0x007E/tgn/mechanical/housing.FCStd

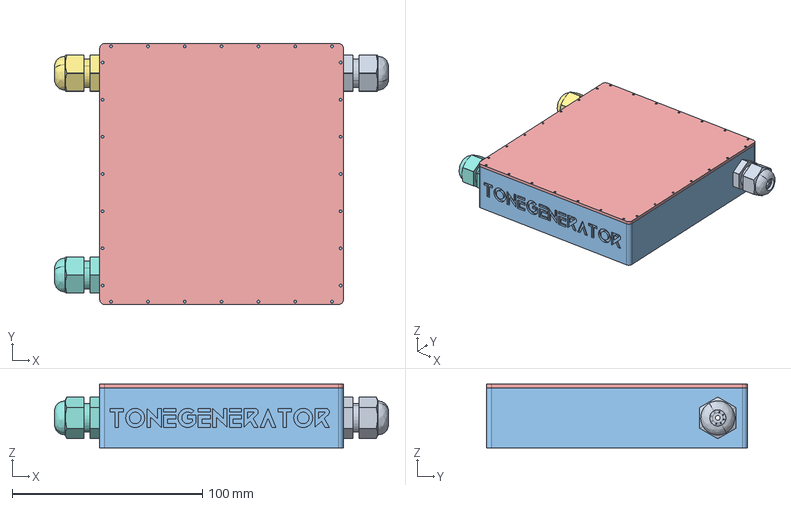
[picture p1: CAD file, 2026-04-13]
mechanical/housing.FCStd
175.5 x 137.1 x 33.5 mm
Pcb_bf5f
J8_TerminalBlock_Phoenix_MKDS_15_2_508_1x02_P508mm_Horizontal_966042dcc371
RV1_Potentiometer_Bourns_3296W_Vertical_bd6c58a47347
R2_R_Axial_DIN0207_L63mm_D25mm_P1016mm_Horizontal_2f8f7165bda0
R5_R_Axial_DIN0207_L63mm_D25mm_P1016mm_Horizontal_7338e84fdc98
R9_R_Axial_DIN0207_L63mm_D25mm_P1016mm_Horizontal_2fbd2a20d477
C22_CP_Radial_D80mm_P350mm_770ae233401d
R21_R_Axial_DIN0207_L63mm_D25mm_P1016mm_Horizontal_0408edf33882
R24_R_Axial_DIN0207_L63mm_D25mm_P1016mm_Horizontal_a47f8ef12ceb
D2_LED_D5.0mm_b938de95e8e3
R28_R_Axial_DIN0207_L63mm_D25mm_P1016mm_Horizontal_7c2d55b14bf2
J11_PinHeader_1x03_P254mm_Vertical_755d7d74a0a2
R19_R_Axial_DIN0207_L63mm_D25mm_P1016mm_Horizontal_fe28b3a22ee2
Q1_TO-92_Wide_a5516702e934
J7_TerminalBlock_Phoenix_MKDS_15_2_508_1x02_P508mm_Horizontal_5398f9b25835
C2_CP_Radial_D80mm_P350mm_c936b49940e3
R13_R_Axial_DIN0207_L63mm_D25mm_P1016mm_Horizontal_583937bb0d57
C12_C_Disc_D50mm_W25mm_P250mm_c4d23a535d06
C16_C_Disc_D50mm_W25mm_P250mm_a4bcc5b5eeba
R27_R_Axial_DIN0207_L63mm_D25mm_P1016mm_Horizontal_b2bb33a8434a
J9_TerminalBlock_Phoenix_MKDS_15_2_508_1x02_P508mm_Horizontal_ed7d2c41be30
U11_DIP_8_W762mm_Socket_48e19bc4034c
C4_CP_Radial_D80mm_P350mm_f4ba60a29ce0
J3_PinHeader_1x02_P254mm_Vertical_3cade2f9eb17
R25_R_Axial_DIN0207_L63mm_D25mm_P1016mm_Horizontal_3ad7011eaaed
U6_DIP_16_W762mm_Socket_05c4fef0970c
C10_C_Disc_D50mm_W25mm_P250mm_e466ce81a680
C15_C_Disc_D50mm_W25mm_P250mm_6bec329688ee
J12_PinHeader_1x03_P254mm_Vertical_b2e7384c09ff
U3_DIP_14_W762mm_Socket_77d9b751a4c5
R3_R_Axial_DIN0207_L63mm_D25mm_P1016mm_Horizontal_e1384053c9d4
U9_DIP_8_W762mm_Socket_c7e6118ec233
U2_DIP_14_W762mm_Socket_1d6f5387526a
J6_PinHeader_1x03_P254mm_Vertical_416229293399
LS1_TerminalBlock_Phoenix_MKDS_15_2_508_1x02_P508mm_Horizontal_cf348314c129
C14_C_Disc_D50mm_W25mm_P250mm_362b8cfb6720
R7_R_Axial_DIN0207_L63mm_D25mm_P1016mm_Horizontal_4b6fb19448ef
R10_R_Axial_DIN0207_L63mm_D25mm_P1016mm_Horizontal_2cd78269121d
U8_DIP_16_W762mm_Socket_b1bc0039ac66
R30_R_Axial_DIN0207_L63mm_D25mm_P1016mm_Horizontal_cbc60847cbaa
C7_C_Disc_D50mm_W25mm_P250mm_bb85d0389fc8
C3_CP_Radial_D80mm_P350mm_c63e61aa70d5
J1_TerminalBlock_Phoenix_MKDS_15_2_508_1x02_P508mm_Horizontal_a53db4caa078
U5_DIP_16_W762mm_Socket_3ae7070fdcc8
R15_R_Axial_DIN0207_L63mm_D25mm_P1016mm_Horizontal_7a1509dda514
C11_C_Disc_D50mm_W25mm_P250mm_a5813d64c108
R14_R_Axial_DIN0207_L63mm_D25mm_P1016mm_Horizontal_d6deb1070b43
R29_R_Axial_DIN0207_L63mm_D25mm_P1016mm_Horizontal_8874abd8c114
J4_PinHeader_1x02_P254mm_Vertical_619bb45d0a5d
F1_100056_ef463b47df8c
F1_100056_ef463b47df8c[2]
U7_DIP_16_W762mm_Socket_4d8cd030cd80
J2_PinHeader_1x02_P254mm_Vertical_04cdee413f5e
D1_D_DO-201_P15.24mm_Horizontal_fedca64ea0a4
C17_C_Disc_D50mm_W25mm_P250mm_d6f6ce41cef2
C5_CP_Radial_D80mm_P350mm_bb47d8a898b0
R8_R_Axial_DIN0207_L63mm_D25mm_P1016mm_Horizontal_bda0a483a1b2
R11_R_Axial_DIN0207_L63mm_D25mm_P1016mm_Horizontal_5b285d104ccb
C18_C_Disc_D50mm_W25mm_P250mm_e7fd411ce769
Q2_TO-92_Wide_e51d8f50bd00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
