0x007E/tgn/pcb/TGN.kicad_pcb

## KiCad design pcb/TGN.kicad_pcb (2026-04-12)

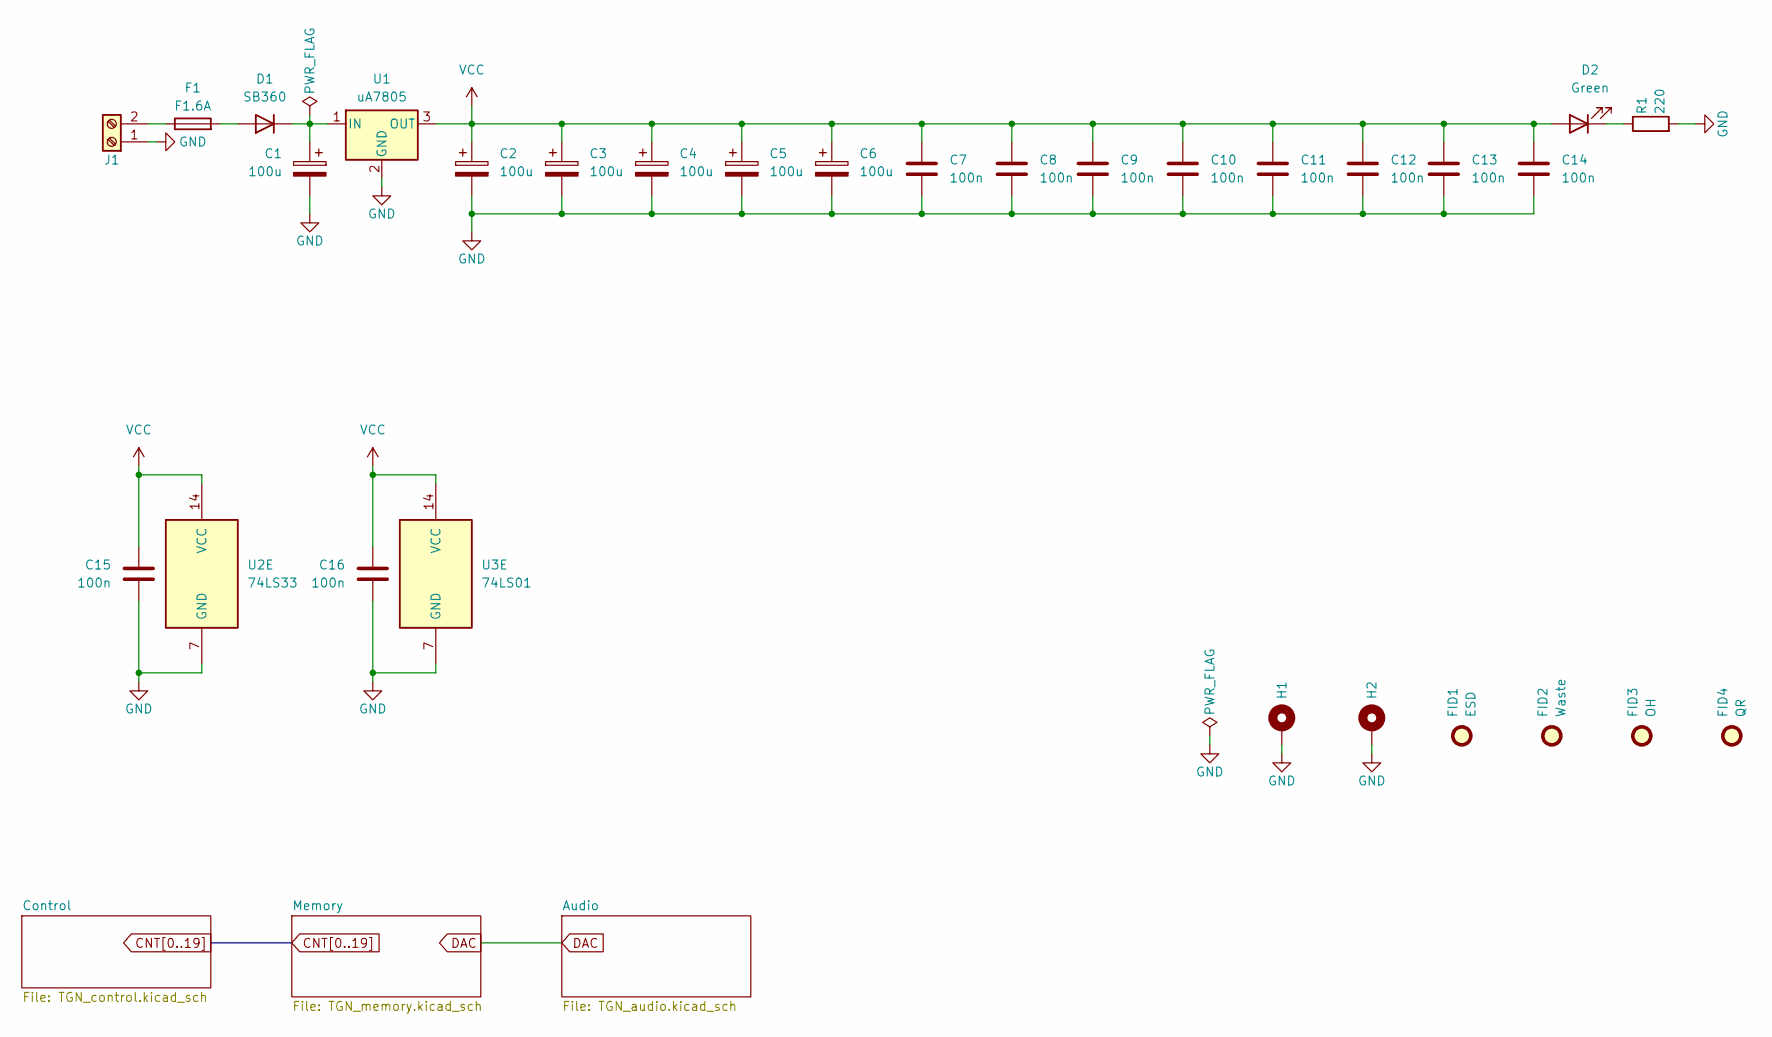
[picture p2: schematic TGN.kicad_sch, ${acronym} - ${title}]

Parts:
C1, C2, C3, C4, C5, C6: 100u; CP_Radial_D8.0mm_P3.50mm
C7, C8, C9, C10, C11, C12, C13, C14, C15, C16: 100n; C_Disc_D5.0mm_W2.5mm_P2.50mm
D1: SB360; D_DO-201_P15.24mm_Horizontal
D2: Green; LED_D5.0mm
F1: F1.6A; Fuse_20mm_HTL
FID1: ESD; ESD-Logo_6.6x6mm_SilkScreen
FID2: Waste; WEEE-Logo_4.2x6mm_SilkScreen
FID3: OH; OSHW-Logo_5.7x6mm_SilkScreen
FID4: QR; QR_0x007e_small
H1, H2: MountingHole_Pad; MountingHole_3.2mm_M3_Pad
J1: Screw_Terminal_01x02; TerminalBlock_Phoenix_MKDS-1,5-2-5.08_1x02_P5.08mm_Horizont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
R1: 220; R_Axial_DIN0207_L6.3mm_D2.5mm_P10.16mm_Horizontal
U1: uA7805; TO-220-3_Vertical
U2: 74LS33; DIP-14_W7.62mm_Socket_LongPads
U3: 74LS01; DIP-14_W7.62mm_Socket_LongPads

Connections:
GND: C1.2, C2.2, C3.2, C4.2, C5.2, C6.2, C7.2, C8.2, C9.2, C10.2, C11.2, C12.2, C13.2, C14.2, C15.2, C16.2, H1.1, H2.1, J1.1, R1.2, U1.2 (GND), U2.7 (GND), U3.7 (GND); also elsewhere on the board
unnamed: D1.2 (A), F1.2
unnamed: C1.1, D1.1 (K), U1.1 (IN)
unnamed: D2.1 (K), R1.1
unnamed: F1.1, J1.2
VCC: C2.1, C3.1, C4.1, C5.1, C6.1, C7.1, C8.1, C9.1, C10.1, C11.1, C12.1, C13.1, C14.1, C15.1, C16.1, D2.2 (A), U1.3 (OUT), U2.14 (VCC), U3.14 (VCC); also elsewhere on the board

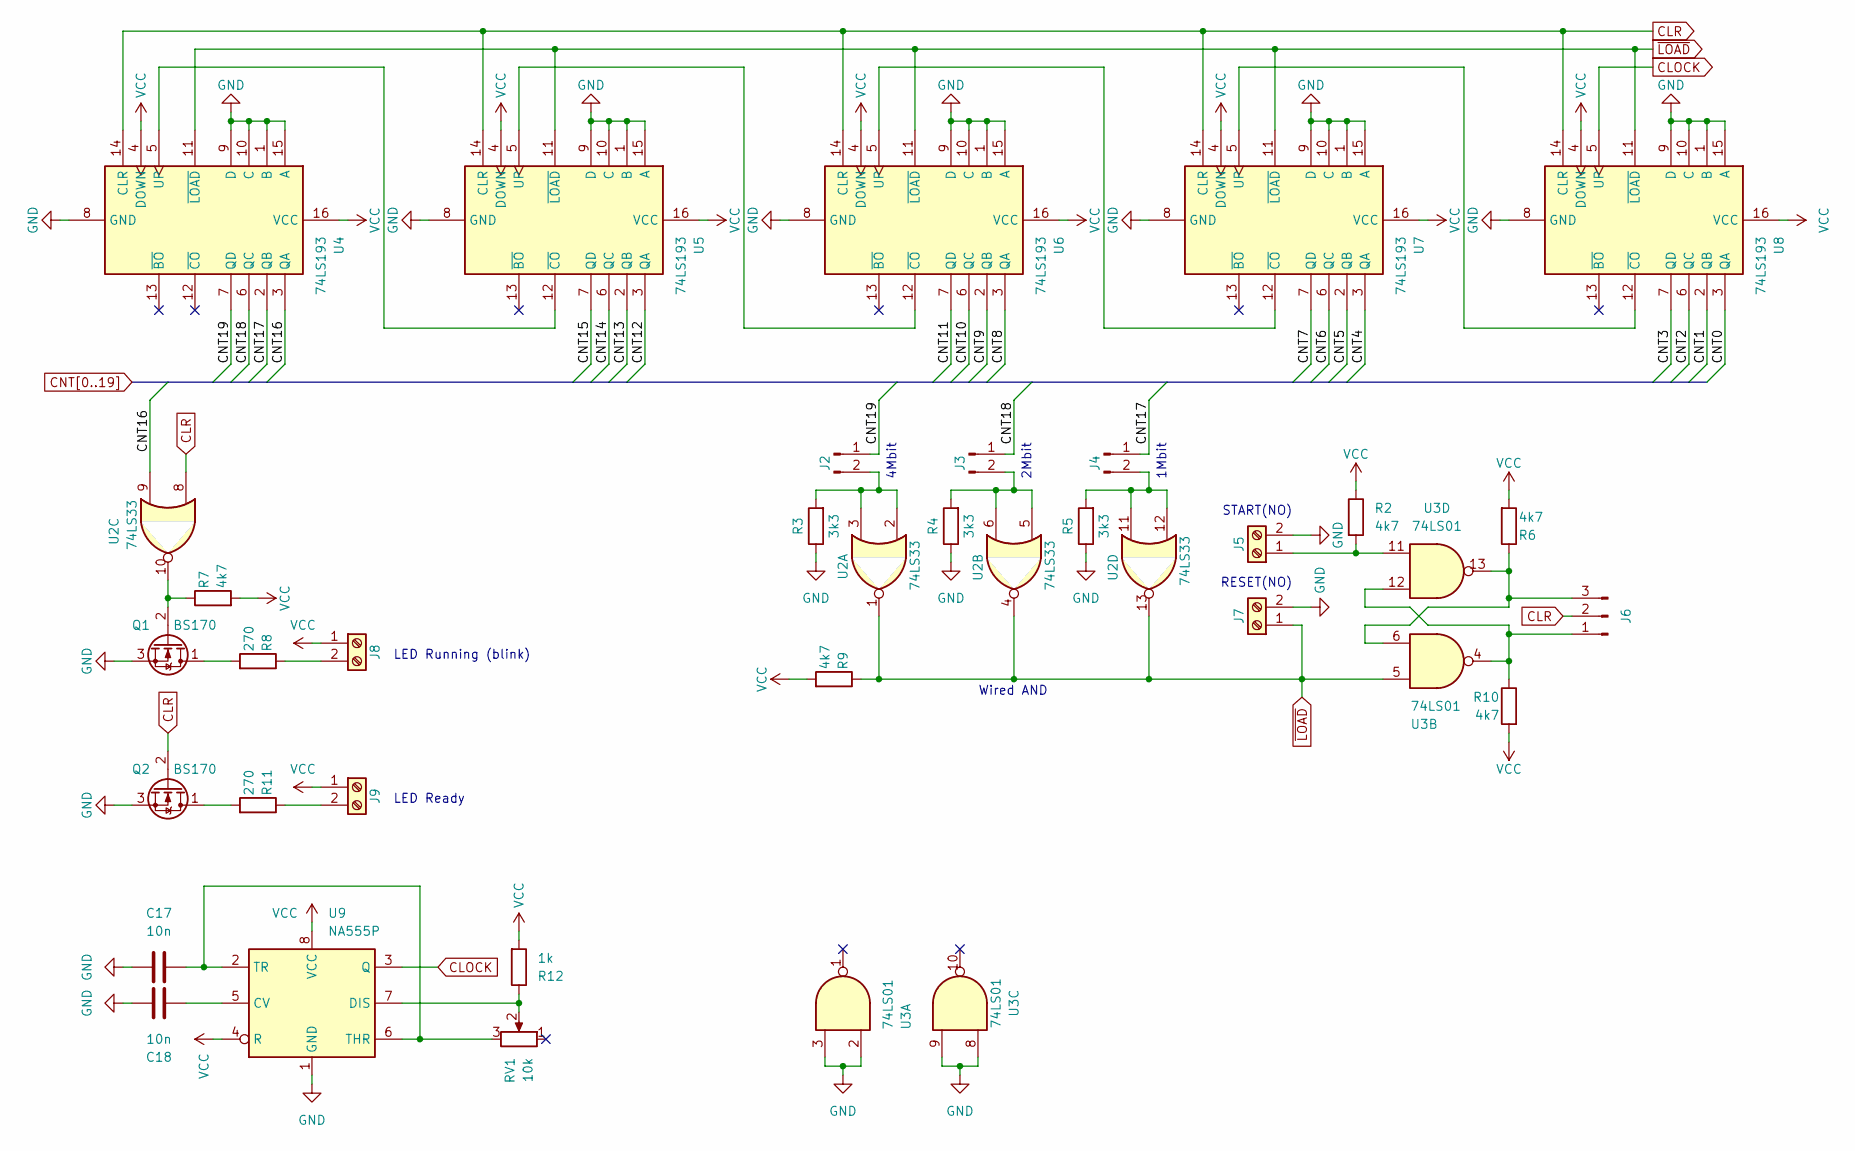
[picture p3: schematic TGN_control.kicad_sch, ${acronym} - ${title}]

Parts:
C17, C18: 10n; C_Disc_D5.0mm_W2.5mm_P2.50mm
J2, J3, J4: Conn_01x02_Pin; PinHeader_1x02_P2.54mm_Vertical
J5, J7, J8, J9: Screw_Terminal_01x02; TerminalBlock_Phoenix_MKDS-1,5-2-5.08_1x02_P5.08mm_Horizont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
J6: Conn_01x03_Pin; PinHeader_1x03_P2.54mm_Vertical
Q1, Q2: BS170; TO-92_Wide
R2, R6, R7, R9, R10: 4k7; R_Axial_DIN0207_L6.3mm_D2.5mm_P10.16mm_Horizontal
R3, R4, R5: 3k3; R_Axial_DIN0207_L6.3mm_D2.5mm_P10.16mm_Horizontal
R8, R11: 270; R_Axial_DIN0207_L6.3mm_D2.5mm_P10.16mm_Horizontal
R12: 1k; R_Axial_DIN0207_L6.3mm_D2.5mm_P10.16mm_Horizontal
RV1: 10k; Potentiometer_Bourns_3296W_Vertical
U2: 74LS33; DIP-14_W7.62mm_Socket_LongPads
U3: 74LS01; DIP-14_W7.62mm_Socket_LongPads
U4, U5, U6, U7, U8: 74LS193; DIP-16_W7.62mm_Socket_LongPads
U9: NA555P; DIP-8_W7.62mm_Socket_LongPads

Connections:
CLOCK: U8.5 (UP), U9.3 (Q)
CLR: J6.2, Q2.2 (G), U2.8, U4.14 (CLR), U5.14 (CLR), U6.14 (CLR), U7.14 (CLR), U8.14 (CLR)
CNT0: U8.3 (QA); also elsewhere on the board
CNT1: U8.2 (QB); also elsewhere on the board
CNT2: U8.6 (QC); also elsewhere on the board
CNT3: U8.7 (QD); also elsewhere on the board
CNT4: U7.3 (QA); also elsewhere on the board
CNT5: U7.2 (QB); also elsewhere on the board
CNT6: U7.6 (QC); also elsewhere on the board
CNT7: U7.7 (QD); also elsewhere on the board
CNT8: U6.3 (QA); also elsewhere on the board
CNT9: U6.2 (QB); also elsewhere on the board
CNT10: U6.6 (QC); also elsewhere on the board
CNT11: U6.7 (QD); also elsewhere on the board
CNT12: U5.3 (QA); also elsewhere on the board
CNT13: U5.2 (QB); also elsewhere on the board
CNT14: U5.6 (QC); also elsewhere on the board
CNT15: U5.7 (QD); also elsewhere on the board
CNT16: U2.9, U4.3 (QA); also elsewhere on the board
CNT17: J4.1, U4.2 (QB); also elsewhere on the board
CNT18: J3.1, U4.6 (QC); also elsewhere on the board
CNT19: J2.1, U4.7 (QD)
GND: C17.1, C18.1, J5.2, J7.2, Q1.3 (S), Q2.3 (S), R3.1, R4.1, R5.1, U3.2, U3.3, U3.8, U3.9, U4.1 (B), U4.8 (GND), U4.9 (D), U4.10 (C), U4.15 (A), U5.1 (B), U5.8 (GND), U5.9 (D), U5.10 (C), U5.15 (A), U6.1 (B), U6.8 (GND), U6.9 (D), U6.10 (C), U6.15 (A), U7.1 (B), U7.8 (GND), U7.9 (D), U7.10 (C), U7.15 (A), U8.1 (B), U8.8 (GND), U8.9 (D), U8.10 (C), U8.15 (A), U9.1 (GND); also elsewhere on the board
unnamed: J2.2, R3.2, U2.2, U2.3
unnamed: J3.2, R4.2, U2.5, U2.6
unnamed: J4.2, R5.2, U2.11, U2.12
unnamed: J5.1, R2.2, U3.11
unnamed: J6.1, R10.1, U3.4, U3.12
unnamed: J6.3, R6.1, U3.6, U3.13
unnamed: J8.2, R8.1
unnamed: J9.2, R11.1
unnamed: Q1.1 (D), R8.2
unnamed: Q1.2 (G), R7.1, U2.10
unnamed: Q2.1 (D), R11.2
unnamed: U4.5 (UP), U5.12 (~CO)
unnamed: U5.5 (UP), U6.12 (~CO)
unnamed: U6.5 (UP), U7.12 (~CO)
unnamed: U7.5 (UP), U8.12 (~CO)
unnamed: C18.2, U9.5 (CV)
unnamed: R12.1, RV1.2, U9.7 (DIS)
unnamed: C17.2, RV1.3, U9.2 (TR), U9.6 (THR)
VCC: J8.1, J9.1, R2.1, R6.2, R7.2, R9.2, R10.2, R12.2, U4.4 (DOWN), U4.16 (VCC), U5.4 (DOWN), U5.16 (VCC), U6.4 (DOWN), U6.16 (VCC), U7.4 (DOWN), U7.16 (VCC), U8.4 (DOWN), U8.16 (VCC), U9.4 (R), U9.8 (VCC); also elsewhere on the board
~LOAD: J7.1, R9.1, U2.1, U2.4, U2.13, U3.5, U4.11 (~LOAD), U5.11 (~LOAD), U6.11 (~LOAD), U7.11 (~LOAD), U8.11 (~LOAD)

Notes on the sheet:
Wired AND
2Mbit
4Mbit
LED Ready
1Mbit
LED Running (blink)
RESET(NO)
START(NO)

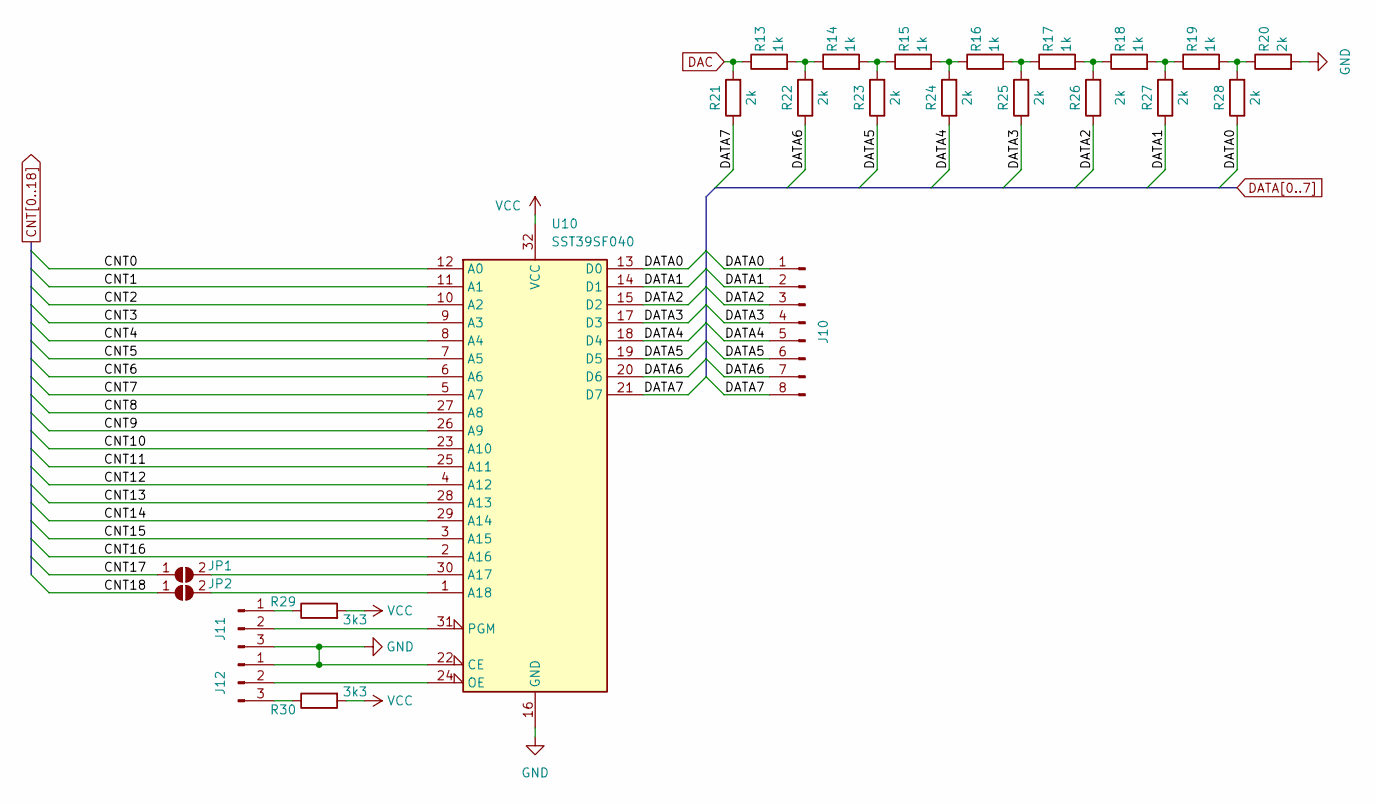
[picture p4: schematic TGN_memory.kicad_sch, ${acronym} - ${title}]

Parts:
J10: Conn_01x08_Pin; PinSocket_1x08_P2.54mm_Vertical
J11, J12: Conn_01x03_Pin; PinHeader_1x03_P2.54mm_Vertical
JP1, JP2: SolderJumper_2_Open; SolderJumper-2_P1.3mm_Open_RoundedPad1.0x1.5mm
R13, R14, R15, R16, R17, R18, R19: 1k; R_Axial_DIN0207_L6.3mm_D2.5mm_P10.16mm_Horizontal
R20, R21, R22, R23, R24, R25, R26, R27, R28: 2k; R_Axial_DIN0207_L6.3mm_D2.5mm_P10.16mm_Horizontal
R29, R30: 3k3; R_Axial_DIN0207_L6.3mm_D2.5mm_P10.16mm_Horizontal
U10: SST39SF040; DIP-32_W15.24mm_LongPads

Connections:
CNT0: U10.12 (A0); also elsewhere on the board
CNT1: U10.11 (A1); also elsewhere on the board
CNT2: U10.10 (A2); also elsewhere on the board
CNT3: U10.9 (A3); also elsewhere on the board
CNT4: U10.8 (A4); also elsewhere on the board
CNT5: U10.7 (A5); also elsewhere on the board
CNT6: U10.6 (A6); also elsewhere on the board
CNT7: U10.5 (A7); also elsewhere on the board
CNT8: U10.27 (A8); also elsewhere on the board
CNT9: U10.26 (A9); also elsewhere on the board
CNT10: U10.23 (A10); also elsewhere on the board
CNT11: U10.25 (A11); also elsewhere on the board
CNT12: U10.4 (A12); also elsewhere on the board
CNT13: U10.28 (A13); also elsewhere on the board
CNT14: U10.29 (A14); also elsewhere on the board
CNT15: U10.3 (A15); also elsewhere on the board
CNT16: U10.2 (A16); also elsewhere on the board
CNT17: JP1.1 (A); also elsewhere on the board
CNT18: JP2.1 (A); also elsewhere on the board
DAC: R13.1, R21.2; also elsewhere on the board
DATA0: J10.1, R28.1, U10.13 (D0)
DATA1: J10.2, R27.1, U10.14 (D1)
DATA2: J10.3, R26.1, U10.15 (D2)
DATA3: J10.4, R25.1, U10.17 (D3)
DATA4: J10.5, R24.1, U10.18 (D4)
DATA5: J10.6, R23.1, U10.19 (D5)
DATA6: J10.7, R22.1, U10.20 (D6)
DATA7: J10.8, R21.1, U10.21 (D7)
GND: J11.3, J12.1, R20.2, U10.16 (GND), U10.22 (CE); also elsewhere on the board
unnamed: J11.1, R29.1
unnamed: J11.2, U10.31 (PGM)
unnamed: J12.2, U10.24 (OE)
unnamed: J12.3, R30.1
unnamed: JP1.2 (B), U10.30 (A17)
unnamed: JP2.2 (B), U10.1 (A18)
unnamed: R13.2, R14.1, R22.2
unnamed: R14.2, R15.1, R23.2
unnamed: R15.2, R16.1, R24.2
unnamed: R16.2, R17.1, R25.2
unnamed: R17.2, R18.1, R26.2
unnamed: R18.2, R19.1, R27.2
unnamed: R19.2, R20.1, R28.2
VCC: R29.2, R30.2, U10.32 (VCC); also elsewhere on the board

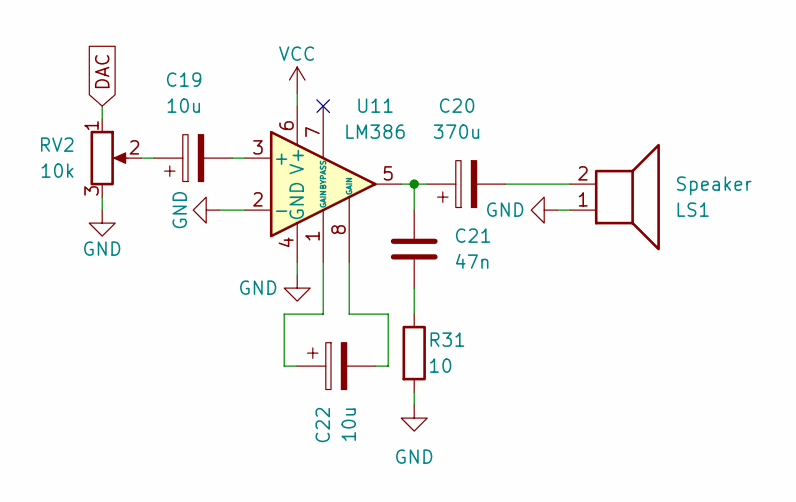
[picture p5: schematic TGN_audio.kicad_sch, ${acronym} - ${title}]

Parts:
C19, C22: 10u; CP_Radial_D8.0mm_P3.50mm
C20: 370u; CP_Radial_D8.0mm_P3.50mm
C21: 47n; C_Disc_D5.0mm_W2.5mm_P2.50mm
LS1: Speaker; TerminalBlock_Phoenix_MKDS-1,5-2-5.08_1x02_P5.08mm_Horizont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
R31: 10; R_Axial_DIN0207_L6.3mm_D2.5mm_P10.16mm_Horizontal
RV2: 10k; Potentiometer_Piher_PT-10-V10_Vertical
U11: LM386; DIP-8_W7.62mm_Socket_LongPads

Connections:
DAC: RV2.1; also elsewhere on the board
GND: LS1.1, R31.2, RV2.3, U11.2 (-), U11.4 (GND); also elsewhere on the board
unnamed: C19.1, RV2.2
unnamed: C20.1, C21.1, U11.5
unnamed: C20.2, LS1.2
unnamed: C21.2, R31.1
unnamed: C22.1, U11.1 (GAIN)
unnamed: C22.2, U11.8 (GAIN)
unnamed: C19.2, U11.3 (+)
VCC: U11.6 (V+); also elsewhere on the board

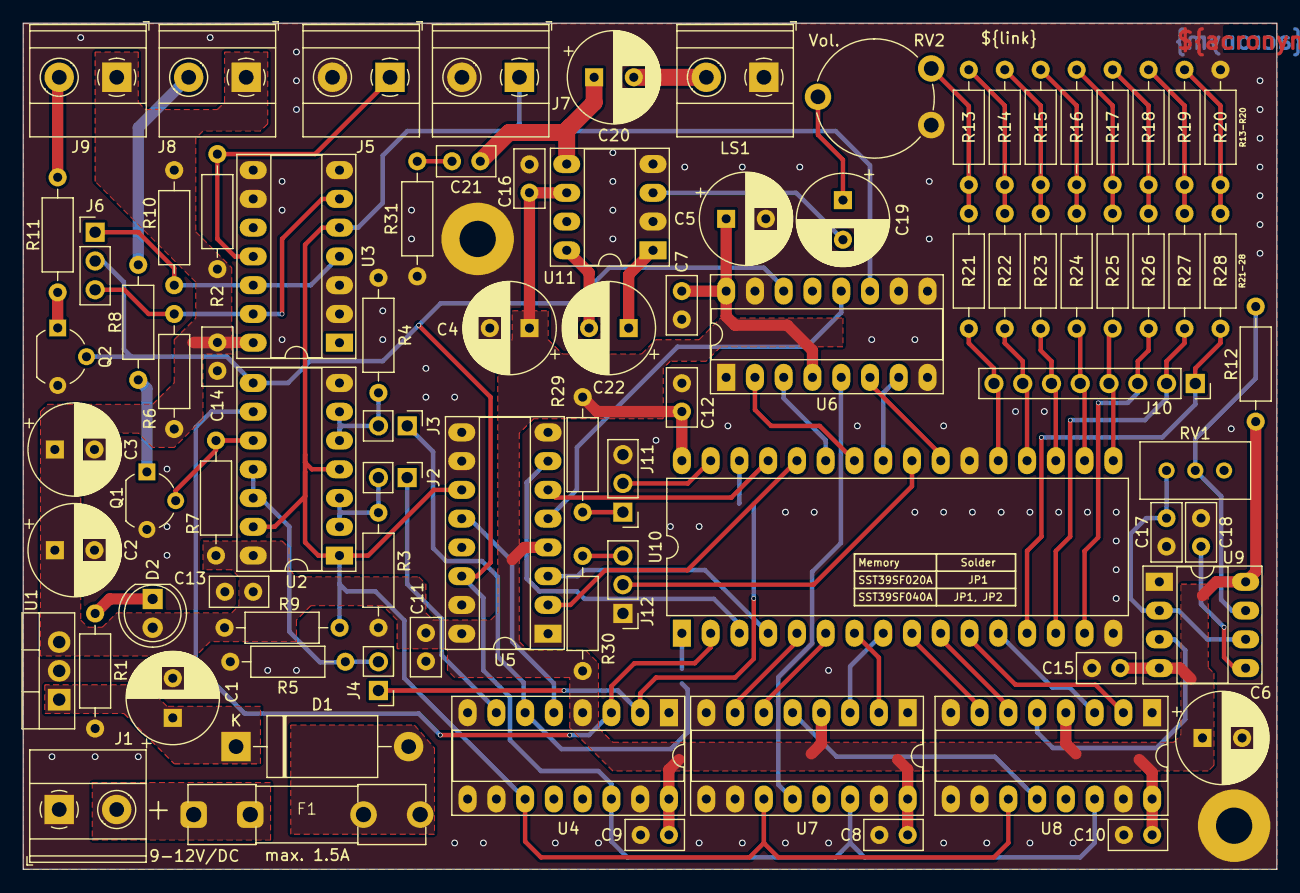
[picture p6: board TGN.kicad_pcb from above]

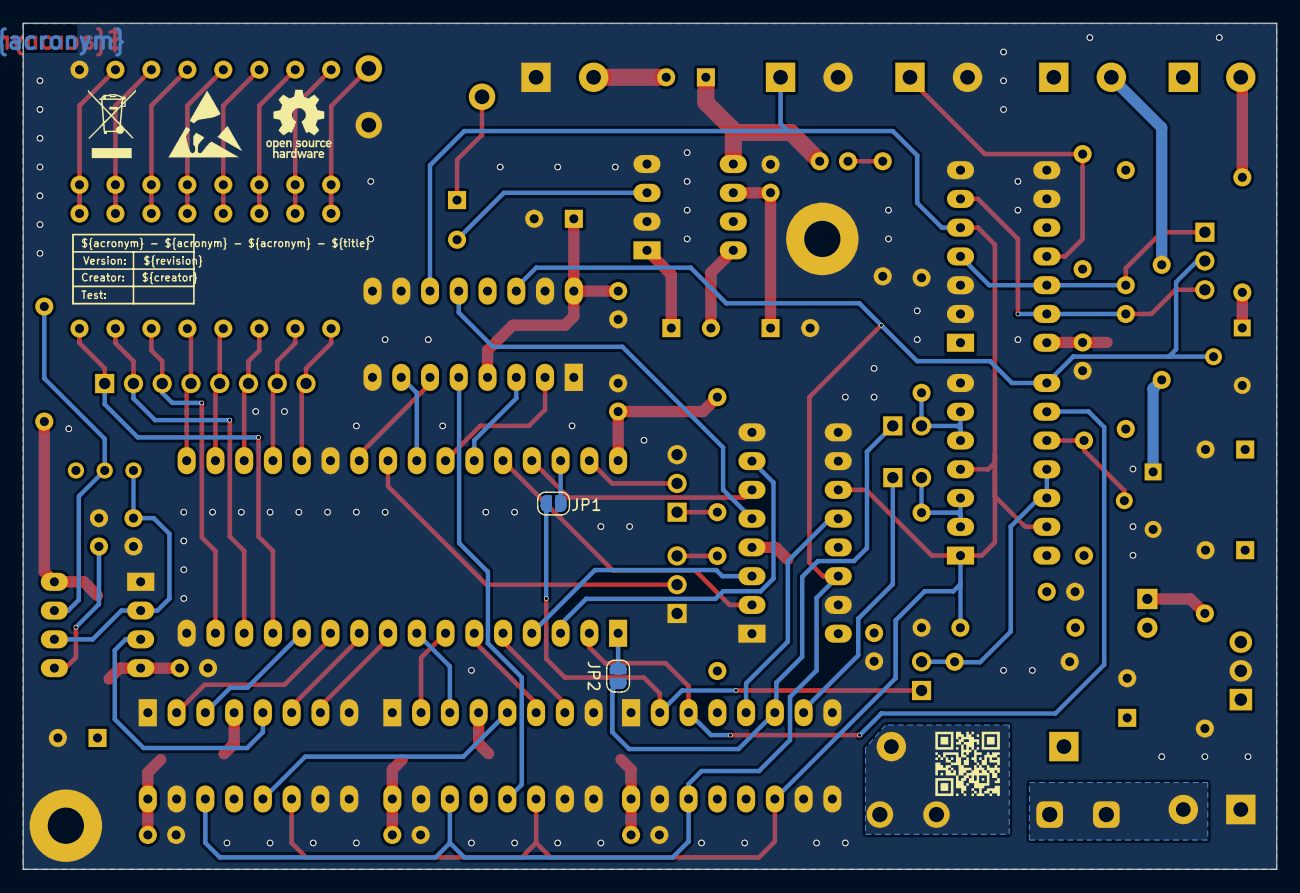
[picture p7: board TGN.kicad_pcb from below]

Board: 2 copper layers, 110.7 x 74.7 mm, 92 parts (6 on the bottom side), 76 nets.
