0x007E/tgn/(commit log)

2026-02-20 Add pcb layout
    [TGN.kicad_pcb, TGN.kicad_sch, TGN_audio.kicad_sch, TGN_control.kicad_sch, TGN_memory.kicad_sch]
2026-02-20 Adapt ladder resistor values
    [TGN.kicad_pcb, TGN_memory.kicad_sch]
2026-04-12 Add dimensioning
    [TGN.kicad_pcb]
2026-04-12 Add mechanical parts
    [housing.FCStd]
2026-04-13 Add heat sink
    [housing.FCStd]
2026-04-13 Add mounting screws and spacers
